NJIT-Solar-Car/can-io-board/assets/CubeMX_Config.png

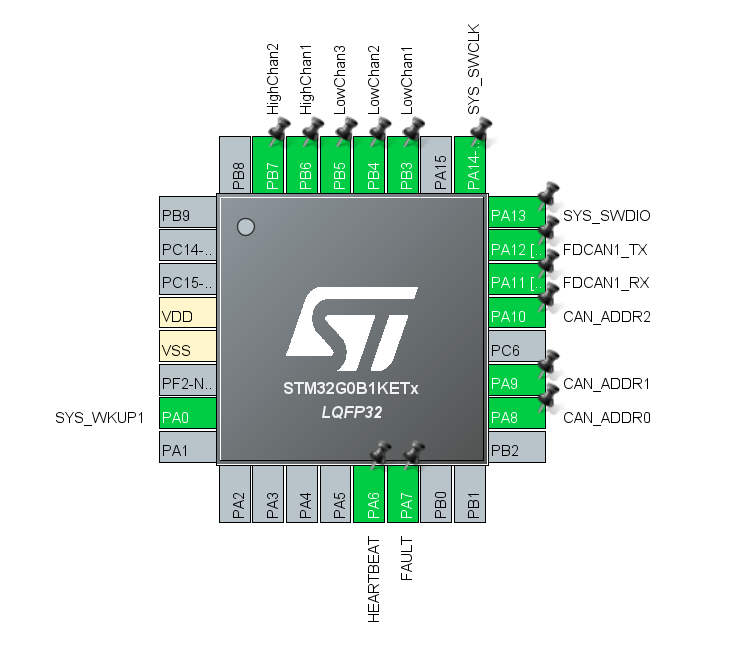
assets/CubeMX_Config.png
