NJIT-Solar-Car/can-io-board/Hardware/CAN.kicad_sch

## KiCad design Hardware/CAN.kicad_sch (2026-06-10)

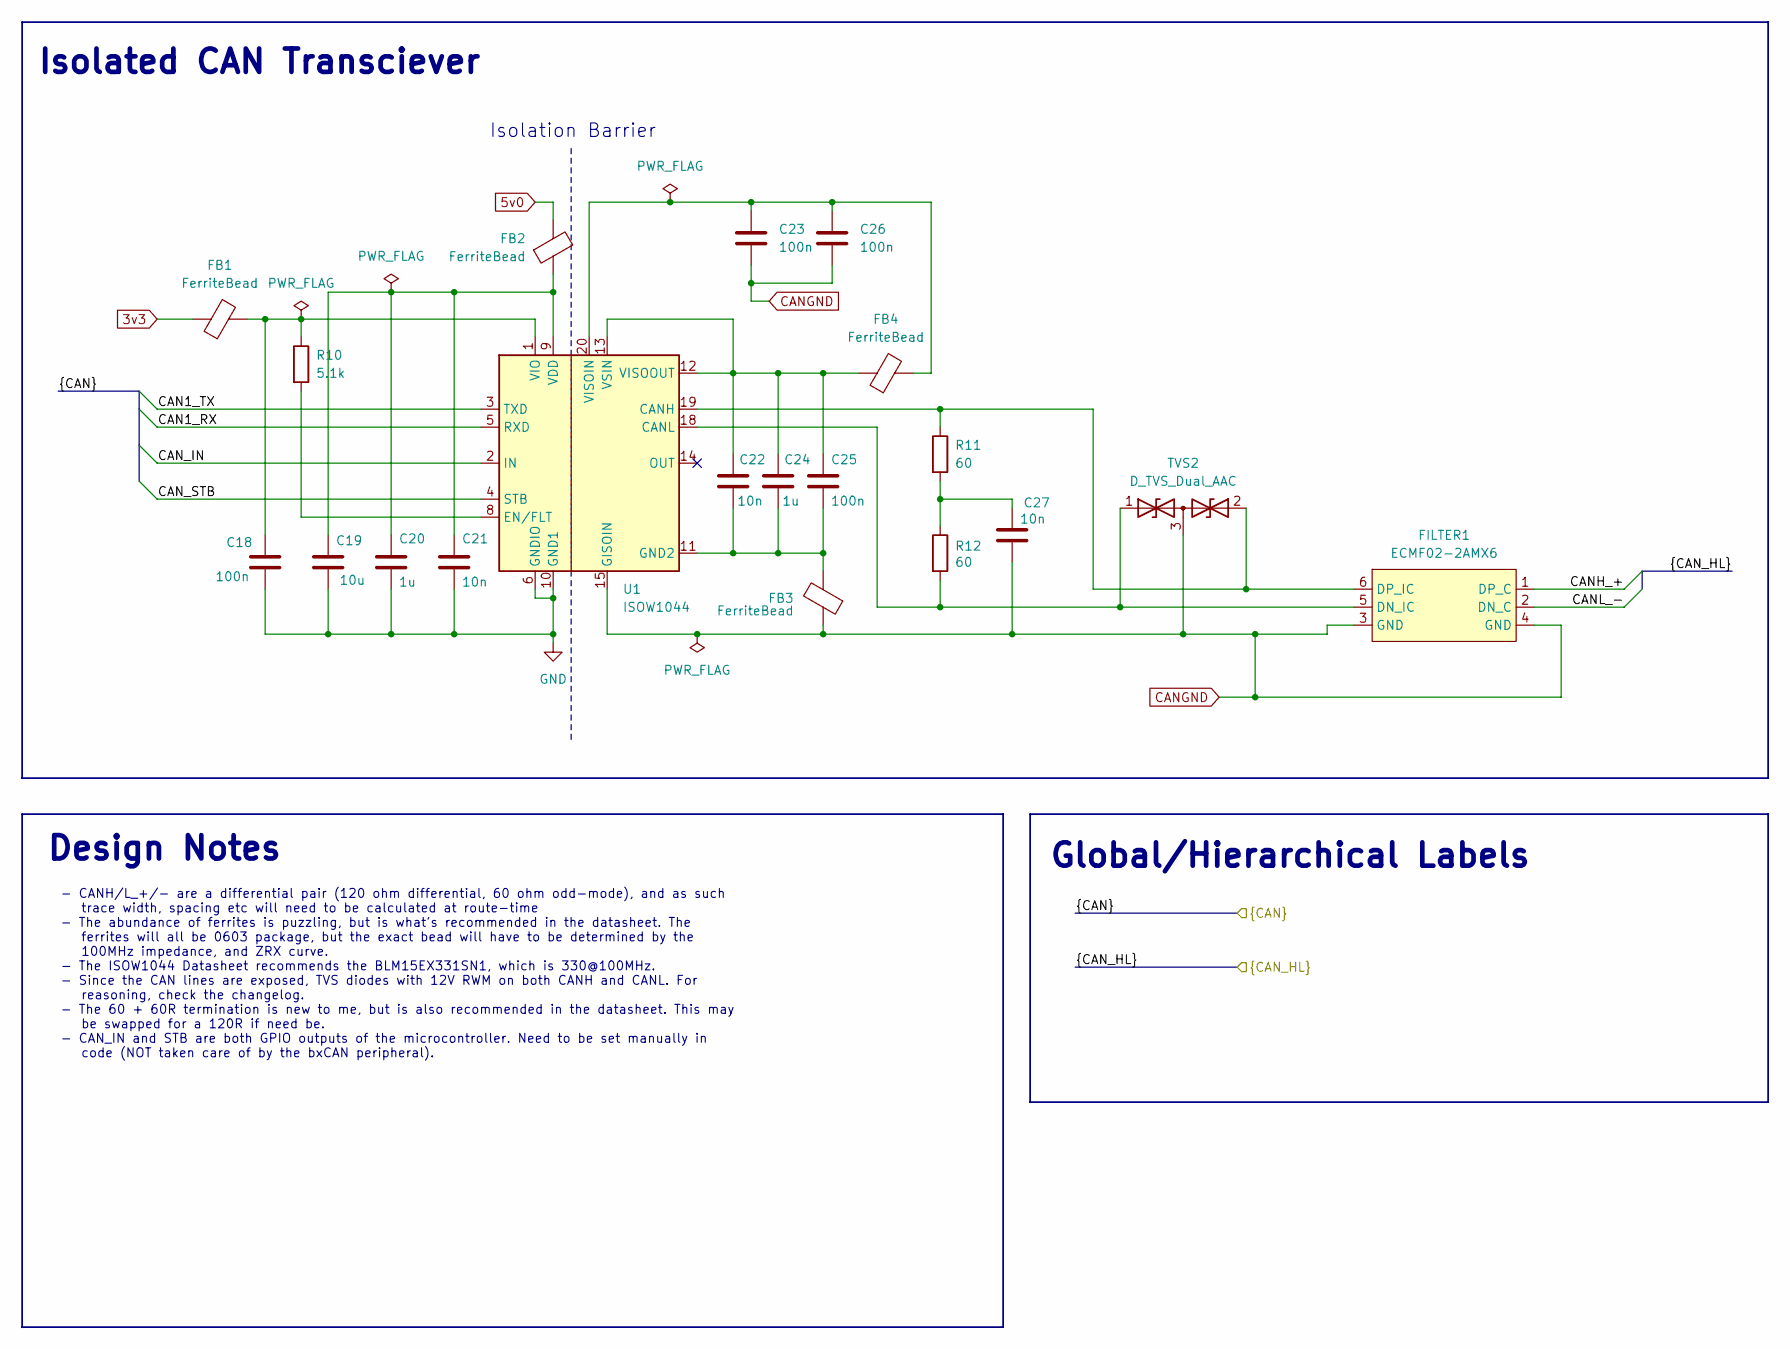
[picture p2: schematic CAN.kicad_sch]

Parts:
C18, C23, C25, C26: 100n; C_0603_1608Metric_Pad1.08x0.95mm_HandSolder
C19: 10u; C_0603_1608Metric_Pad1.08x0.95mm_HandSolder
C20, C24: 1u; C_0603_1608Metric_Pad1.08x0.95mm_HandSolder
C21, C22, C27: 10n; C_0603_1608Metric_Pad1.08x0.95mm_HandSolder
FB1, FB2, FB3, FB4: FerriteBead; L_0603_1608Metric_Pad1.05x0.95mm_HandSolder
FILTER1: ECMF02-2AMX6
R10: 5.1k; R_0603_1608Metric_Pad0.98x0.95mm_HandSolder
R11, R12: 60; R_0603_1608Metric_Pad0.98x0.95mm_HandSolder
TVS2: D_TVS_Dual_AAC; SOT-23-3
U1: ISOW1044; SOIC-20W_7.5x12.8mm_P1.27mm

Connections:
3v3: FB1.1
5v0: FB2.2
CAN1_RX: U1.5 (RXD)
CAN1_TX: U1.3 (TXD)
CANGND: C23.2, C26.2, C27.2, FB3.1, FILTER1.3 (GND), FILTER1.4 (GND), TVS2.3 (common), U1.15 (GISOIN), U1.16 (GISOIN), U1.17 (GISOIN)
CANH_+: FILTER1.1 (DP_C)
CANL_-: FILTER1.2 (DN_C)
CAN_IN: U1.2 (IN)
CAN_STB: U1.4 (STB)
GND: C18.2, C19.2, C20.2, C21.2, U1.6 (GNDIO), U1.10 (GND1)
unnamed: C18.1, FB1.2, R10.1, U1.1 (VIO)
unnamed: C19.1, C20.1, C21.1, FB2.1, U1.9 (VDD)
unnamed: C22.1, C24.1, C25.1, FB4.1, U1.12 (VISOOUT), U1.13 (VSIN)
unnamed: C22.2, C24.2, C25.2, FB3.2, U1.11 (GND2)
unnamed: C23.1, C26.1, FB4.2, U1.20 (VISOIN)
unnamed: C27.1, R11.2, R12.1
unnamed: FILTER1.5 (DN_IC), R12.2, TVS2.1 (A1), U1.18 (CANL)
unnamed: FILTER1.6 (DP_IC), R11.1, TVS2.2 (A2), U1.19 (CANH)
unnamed: R10.2, U1.8 (EN/FLT)

Notes on the sheet:
- CANH/L_+/- are a differential pair (120 ohm differential, 60 ohm odd-mode), and as such trace width, spacing etc will need to be calculated at route-time - The abundance of ferrites is puzzling, but is what's recommended in the datasheet. The ferrites will all be 0603 package, but the exact bead 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
Design Notes
Isolated CAN Transciever
Global/Hierarchical Labels
Isolation Barrier
