NJIT-Solar-Car/can-io-board/Hardware/Connectors.kicad_sch

## KiCad design Hardware/Connectors.kicad_sch (2026-06-10)

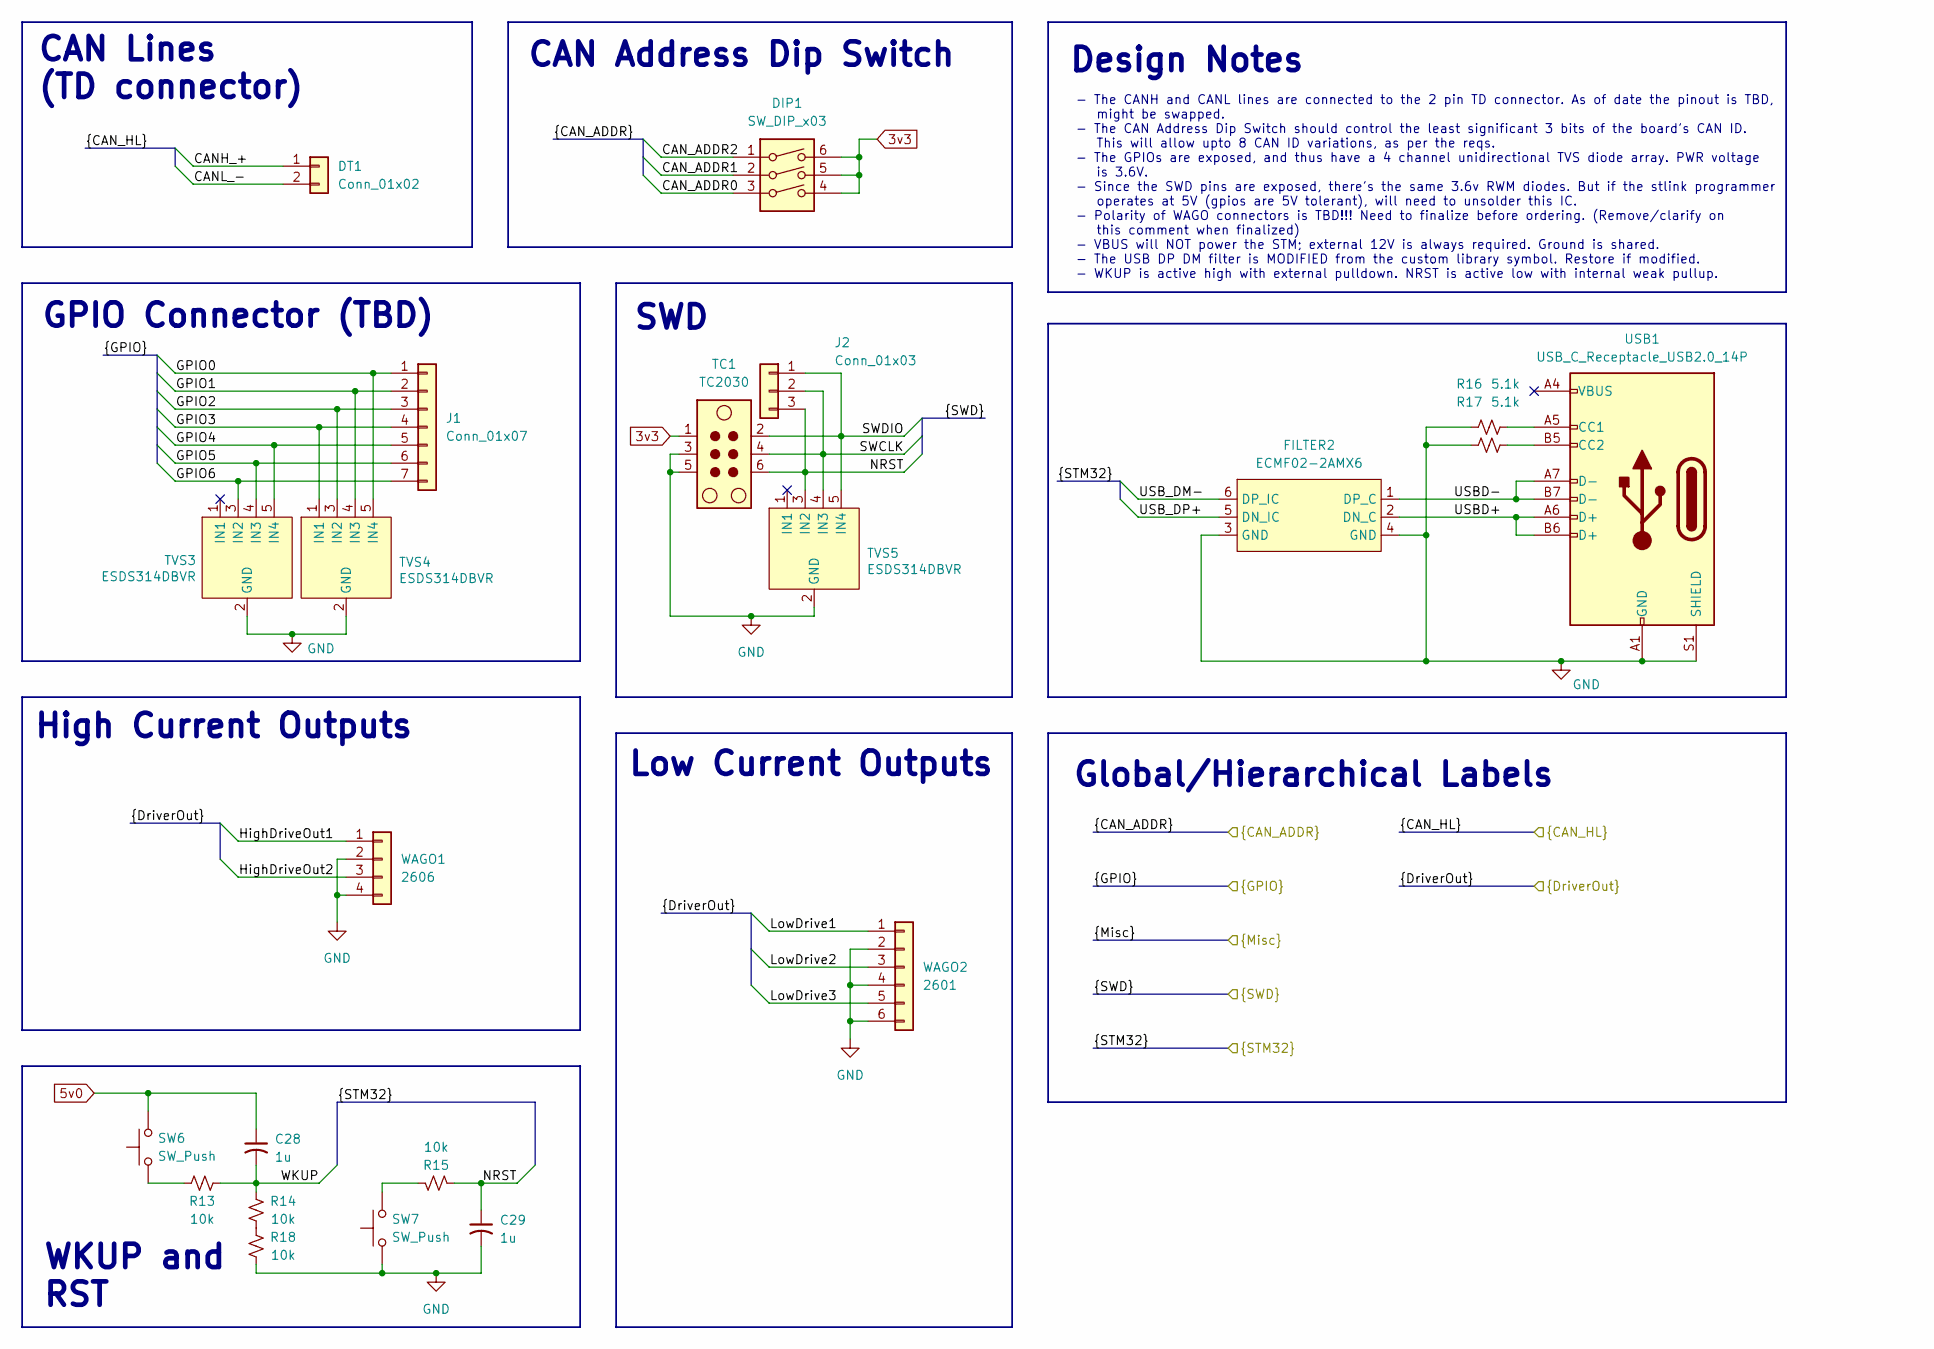
[picture p3: schematic Connectors.kicad_sch]

Parts:
C28, C29: 1u; C_0603_1608Metric_Pad1.08x0.95mm_HandSolder
DIP1: SW_DIP_x03; SW_DIP_SPSTx03_Slide_9.78x9.8mm_W7.62mm_P2.54mm
DT1: Conn_01x02; TerminalBlock_MaiXu_MX126-5.0-02P_1x02_P5.00mm
FILTER2: ECMF02-2AMX6
J1: Conn_01x07; PinHeader_1x07_P2.54mm_Vertical
J2: Conn_01x03; PinHeader_1x03_P2.54mm_Vertical
R13, R14, R15, R18: 10k; R_0603_1608Metric_Pad0.98x0.95mm_HandSolder
R16, R17: 5.1k; R_0603_1608Metric_Pad0.98x0.95mm_HandSolder
SW6, SW7: SW_Push; SW_Push_1P1T_NO_CK_KSC7xxJ
TC1: TC2030; Tag-Connect_TC2030-IDC-NL_2x03_P1.27mm_Vertical
TVS3, TVS4, TVS5: ESDS314DBVR; SOT-23-5
USB1: USB_C_Receptacle_USB2.0_14P
WAGO1: 2606
WAGO2: 2601; TerminalBlock_WAGO_2601-1106_1x06_P3.50mm_Horizontal

Connections:
3v3: DIP1.4, DIP1.5, DIP1.6, TC1.1
5v0: C28.1, SW6.2
CANH_+: DT1.1
CANL_-: DT1.2
CAN_ADDR0: DIP1.3
CAN_ADDR1: DIP1.2
CAN_ADDR2: DIP1.1
GND: C29.2, FILTER2.3 (GND), FILTER2.4 (GND), R16.1, R17.1, R18.2, SW7.1, TC1.3, TC1.5, TVS3.2 (GND), TVS4.2 (GND), TVS5.2 (GND), USB1.A1 (GND), USB1.A12 (GND), USB1.B1 (GND), USB1.B12 (GND), USB1.S1 (SHIELD), WAGO1.2, WAGO1.4, WAGO2.2, WAGO2.4, WAGO2.6
GPIO0: J1.1, TVS4.5 (IN4)
GPIO1: J1.2, TVS4.4 (IN3)
GPIO2: J1.3, TVS4.3 (IN2)
GPIO3: J1.4, TVS4.1 (IN1)
GPIO4: J1.5, TVS3.5 (IN4)
GPIO5: J1.6, TVS3.4 (IN3)
GPIO6: J1.7, TVS3.3 (IN2)
HighDriveOut1: WAGO1.1
HighDriveOut2: WAGO1.3
LowDrive1: WAGO2.1
LowDrive2: WAGO2.3
LowDrive3: WAGO2.5
NRST: C29.1, J2.3, R15.1, TC1.6, TVS5.3 (IN2)
unnamed: R13.2, SW6.1
unnamed: R14.2, R18.1
unnamed: R15.2, SW7.2
unnamed: R16.2, USB1.A5 (CC1)
unnamed: R17.2, USB1.B5 (CC2)
unnamed: USB1.A4 (VBUS), USB1.A9 (VBUS), USB1.B4 (VBUS), USB1.B9 (VBUS)
SWCLK: J2.2, TC1.4, TVS5.4 (IN3)
SWDIO: J2.1, TC1.2, TVS5.5 (IN4)
USBD+: FILTER2.2 (DN_C), USB1.A6 (D+), USB1.B6 (D+)
USBD-: FILTER2.1 (DP_C), USB1.A7 (D-), USB1.B7 (D-)
USB_DM-: FILTER2.6 (DP_IC)
USB_DP+: FILTER2.5 (DN_IC)
WKUP: C28.2, R13.1, R14.1

Notes on the sheet:
High Current Outputs
Low Current Outputs
CAN Lines (TD connector)
CAN Address Dip Switch
SWD
WKUP and RST
- The CANH and CANL lines are connected to the 2 pin TD connector. As of date the pinout is TBD, might be swapped. - The CAN Address Dip Switch should control the least significant 3 bits of the board's CAN ID. This will allow upto 8 CAN ID variations, as per the reqs. - The GPIOs are exposed, and 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
Global/Hierarchical Labels
Design Notes
GPIO Connector (TBD)
