NJIT-Solar-Car/can-io-board/Hardware/Load_Driver.kicad_sch

## KiCad design Hardware/Load_Driver.kicad_sch (2026-06-10)

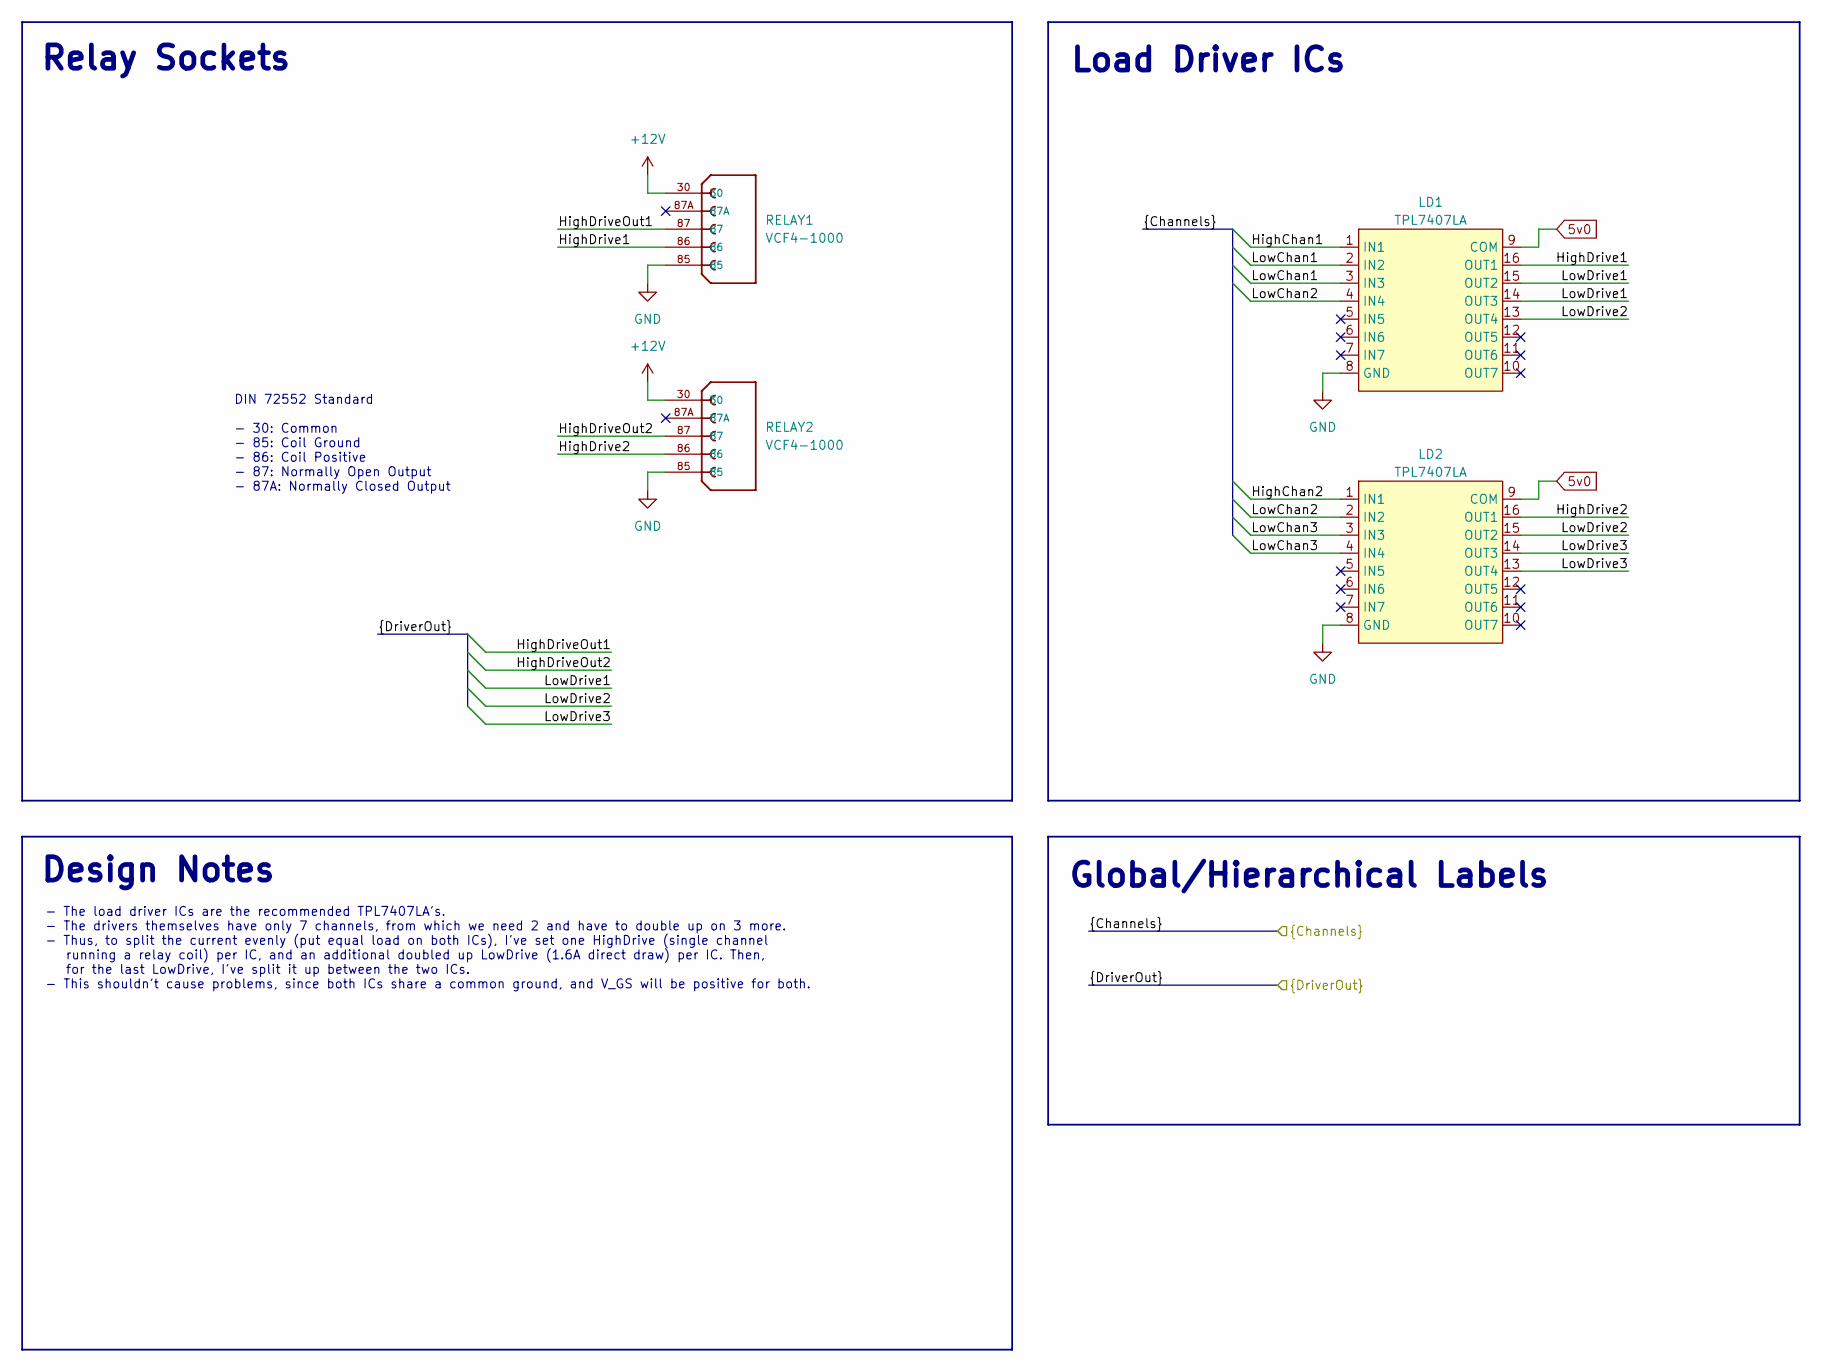
[picture p4: schematic Load_Driver.kicad_sch]

Parts:
LD1, LD2: TPL7407LA; SOIC-16_3.9x9.9mm_P1.27mm
RELAY1, RELAY2: VCF4-1000; TE_VCF4-1000; PARTREV B

Connections:
5v0: LD1.9 (COM), LD2.9 (COM)
+12V: RELAY1.30, RELAY2.30
GND: LD1.8 (GND), LD2.8 (GND), RELAY1.85, RELAY2.85
HighChan1: LD1.1 (IN1)
HighChan2: LD2.1 (IN1)
HighDrive1: LD1.16 (OUT1), RELAY1.86
HighDrive2: LD2.16 (OUT1), RELAY2.86
HighDriveOut1: RELAY1.87
HighDriveOut2: RELAY2.87
LowChan1: LD1.2 (IN2), LD1.3 (IN3)
LowChan2: LD1.4 (IN4), LD2.2 (IN2)
LowChan3: LD2.3 (IN3), LD2.4 (IN4)
LowDrive1: LD1.14 (OUT3), LD1.15 (OUT2)
LowDrive2: LD1.13 (OUT4), LD2.15 (OUT2)
LowDrive3: LD2.13 (OUT4), LD2.14 (OUT3)

Notes on the sheet:
Relay Sockets
Load Driver ICs
Design Notes
- The load driver ICs are the recommended TPL7407LA's. - The drivers themselves have only 7 channels, from which we need 2 and have to double up on 3 more. - Thus, to split the current evenly (put equal load on both ICs), I've set one HighDrive (single channel running a relay coil) per IC, and an a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
Global/Hierarchical Labels
DIN 72552 Standard - 30: Common - 85: Coil Ground - 86: Coil Positive - 87: Normally Open Output - 87A: Normally Closed Output
