NJIT-Solar-Car/can-io-board/Hardware/Power.kicad_sch

## KiCad design Hardware/Power.kicad_sch (2026-06-10)

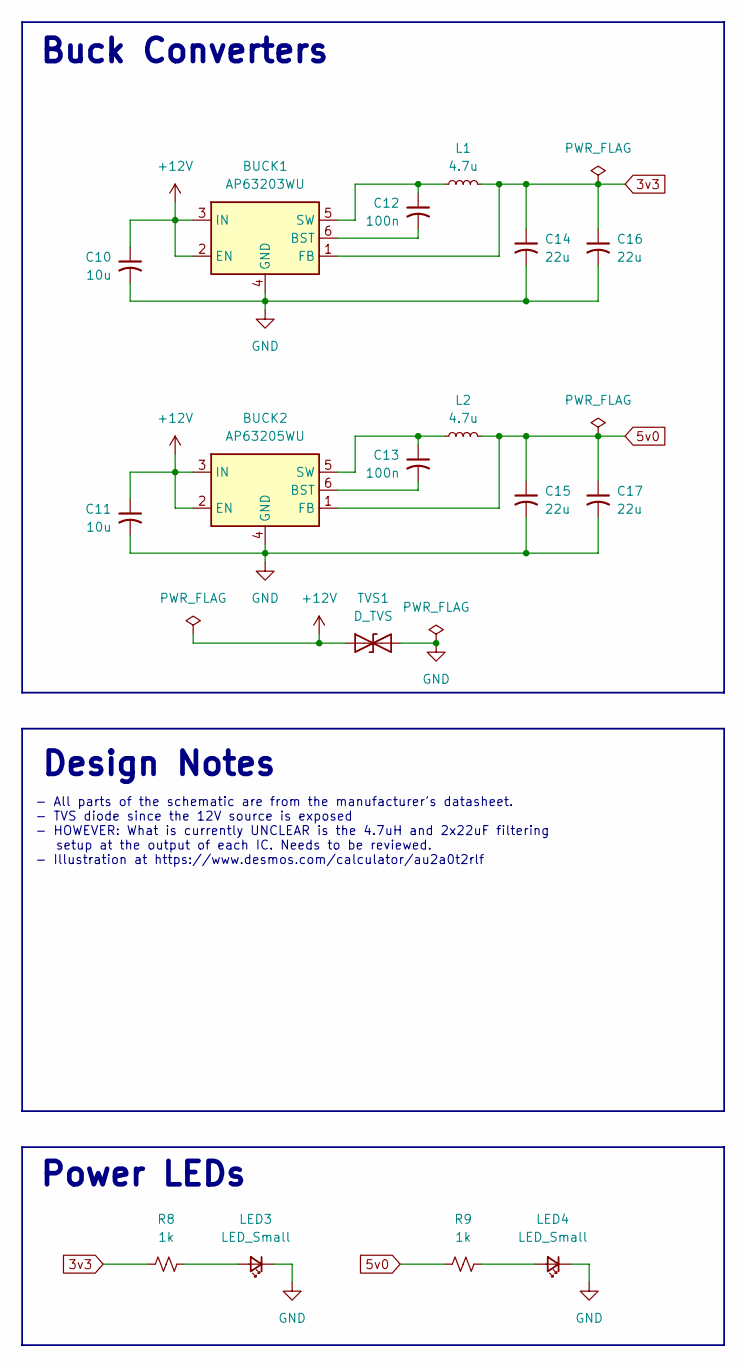
[picture p5: schematic Power.kicad_sch]

Parts:
BUCK1: AP63203WU; TSOT-23-6
BUCK2: AP63205WU; TSOT-23-6
C10, C11: 10u; C_0603_1608Metric_Pad1.08x0.95mm_HandSolder
C12, C13: 100n; C_0603_1608Metric_Pad1.08x0.95mm_HandSolder
C14, C15, C16, C17: 22u; CP_Elec_4x4.5
L1, L2: 4.7u; L_Axial_L7.0mm_D3.3mm_P5.08mm_Vertical_Fastron_MICC
LED3, LED4: LED_Small; LED_1206_3216Metric_Pad1.42x1.75mm_HandSolder
R8, R9: 1k; R_0603_1608Metric_Pad0.98x0.95mm_HandSolder
TVS1: D_TVS; D_SMA_Handsoldering

Connections:
3v3: BUCK1.1 (FB), C14.1, C16.1, L1.2, R8.1
5v0: BUCK2.1 (FB), C15.1, C17.1, L2.2, R9.1
+12V: BUCK1.2 (EN), BUCK1.3 (IN), BUCK2.2 (EN), BUCK2.3 (IN), C10.1, C11.1, TVS1.1 (A1)
GND: BUCK1.4 (GND), BUCK2.4 (GND), C10.2, C11.2, C14.2, C15.2, C16.2, C17.2, LED3.1 (K), LED4.1 (K), TVS1.2 (A2)
unnamed: BUCK1.5 (SW), C12.1, L1.1
unnamed: BUCK1.6 (BST), C12.2
unnamed: BUCK2.5 (SW), C13.1, L2.1
unnamed: BUCK2.6 (BST), C13.2
unnamed: LED3.2 (A), R8.2
unnamed: LED4.2 (A), R9.2

Notes on the sheet:
- All parts of the schematic are from the manufacturer's datasheet. - TVS diode since the 12V source is exposed - HOWEVER: What is currently UNCLEAR is the 4.7uH and 2x22uF filtering setup at the output of each IC. Needs to be reviewed. - Illustration at https://www.desmos.com/calculator/au2a0t2rlf
Buck Converters
Power LEDs
Design Notes
