NJIT-Solar-Car/can-io-board/Hardware/STM32G0B1.kicad_sch

## KiCad design Hardware/STM32G0B1.kicad_sch (2026-06-10)

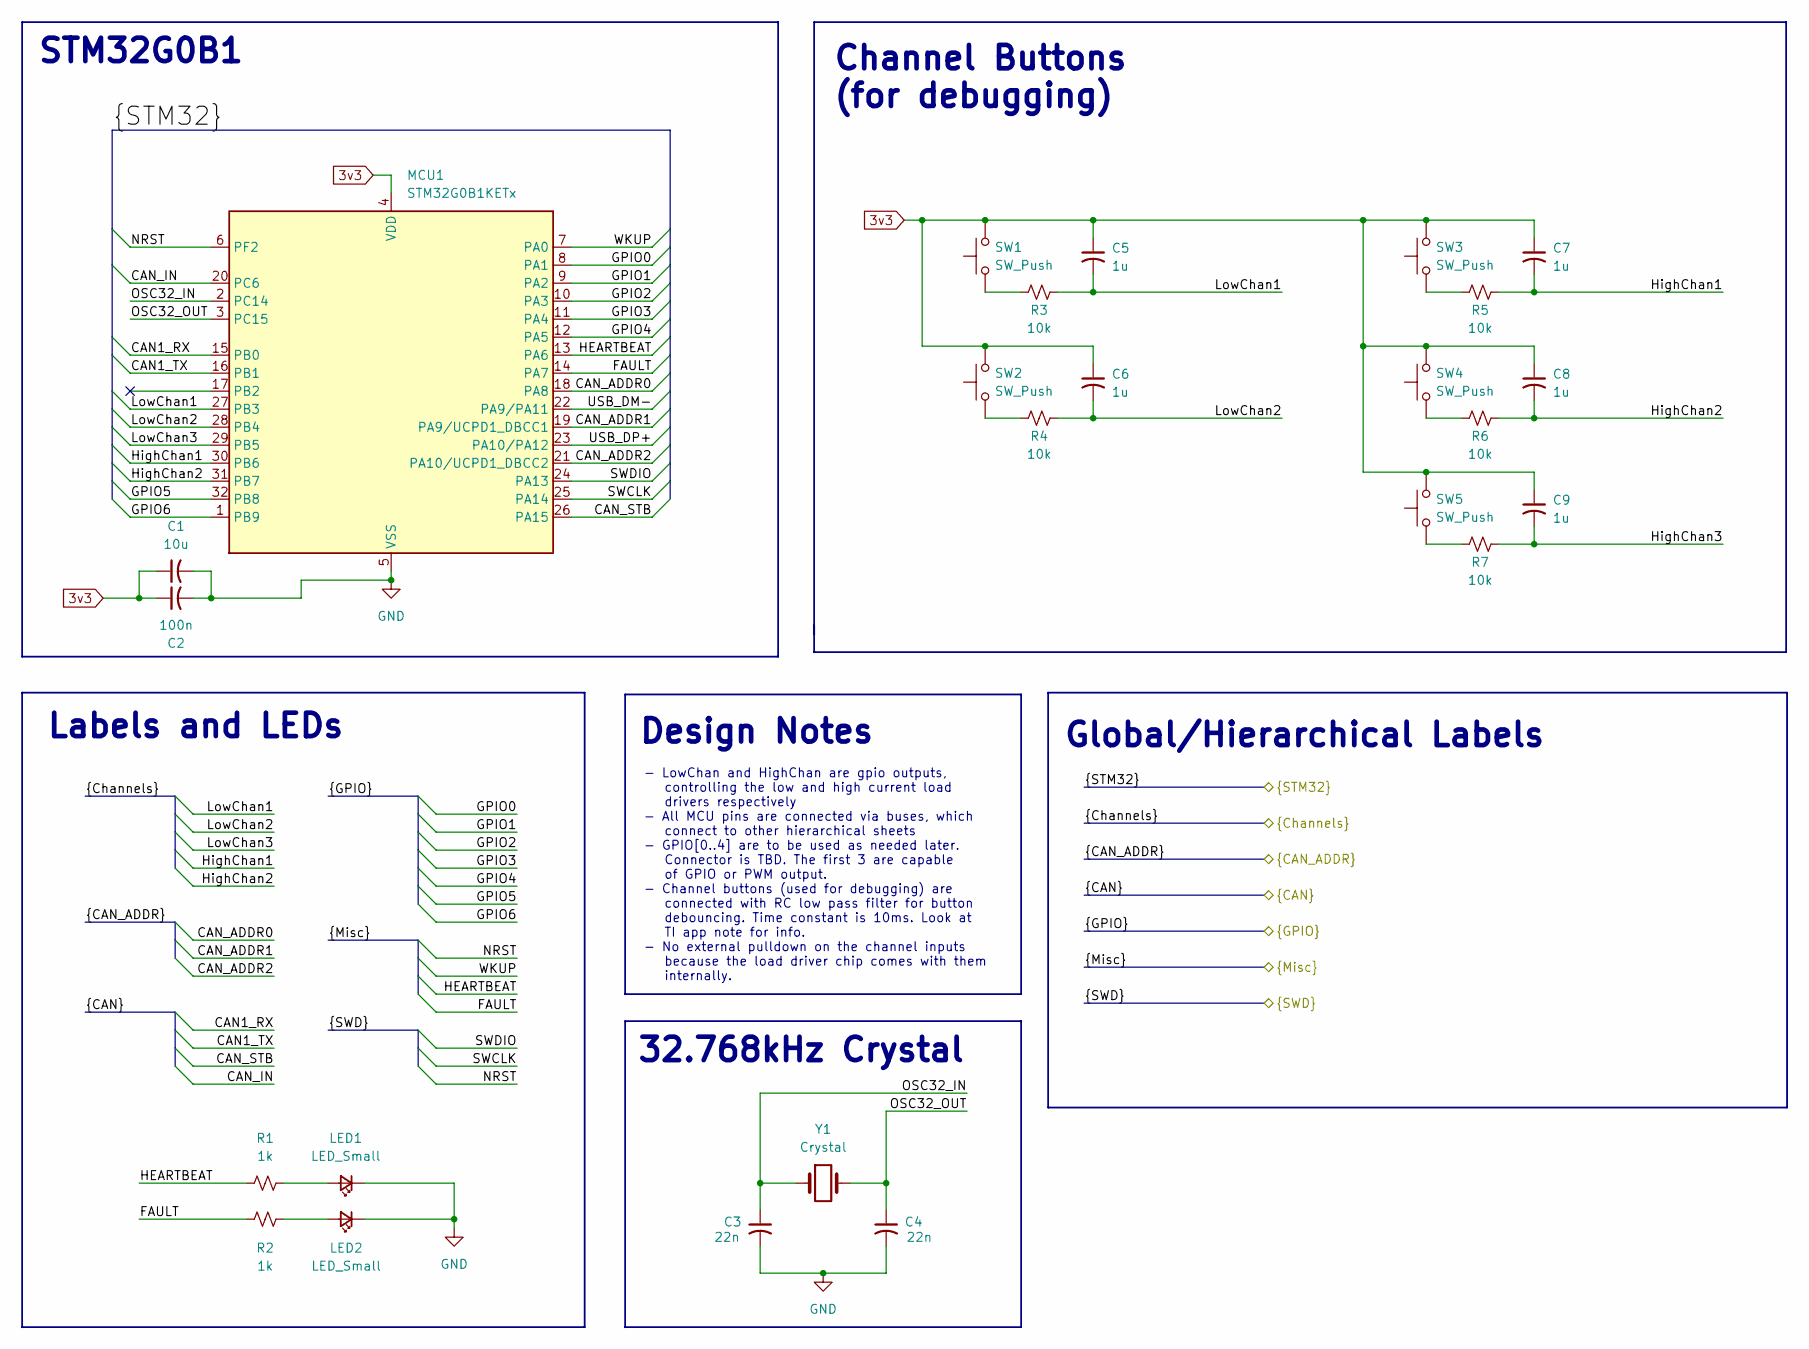
[picture p6: schematic STM32G0B1.kicad_sch]

Parts:
C1: 10u; C_0603_1608Metric_Pad1.08x0.95mm_HandSolder
C2: 100n; C_0603_1608Metric_Pad1.08x0.95mm_HandSolder
C3, C4: 22n; C_0603_1608Metric_Pad1.08x0.95mm_HandSolder
C5, C6, C7, C8, C9: 1u; C_0603_1608Metric_Pad1.08x0.95mm_HandSolder
LED1, LED2: LED_Small; LED_1206_3216Metric_Pad1.42x1.75mm_HandSolder
MCU1: STM32G0B1KETx; LQFP-32_7x7mm_P0.8mm
R1, R2: 1k; R_0603_1608Metric_Pad0.98x0.95mm_HandSolder
R3, R4, R5, R6, R7: 10k; R_0603_1608Metric_Pad0.98x0.95mm_HandSolder
SW1, SW2, SW3, SW4, SW5: SW_Push; SW_Push_1P1T_NO_CK_KSC7xxJ
Y1: Crystal; Crystal_SMD_3215-2Pin_3.2x1.5mm

Connections:
3v3: C1.1, C2.1, C5.1, C6.1, C7.1, C8.1, C9.1, MCU1.4 (VDD), SW1.2, SW2.2, SW3.2, SW4.2, SW5.2
CAN1_RX: MCU1.15 (PB0)
CAN1_TX: MCU1.16 (PB1)
CAN_ADDR0: MCU1.18 (PA8)
CAN_ADDR1: MCU1.19 (PA9/UCPD1_DBCC1)
CAN_ADDR2: MCU1.21 (PA10/UCPD1_DBCC2)
CAN_IN: MCU1.20 (PC6)
CAN_STB: MCU1.26 (PA15)
FAULT: MCU1.14 (PA7), R2.1
GND: C1.2, C2.2, C3.2, C4.2, LED1.1 (K), LED2.1 (K), MCU1.5 (VSS)
GPIO0: MCU1.8 (PA1)
GPIO1: MCU1.9 (PA2)
GPIO2: MCU1.10 (PA3)
GPIO3: MCU1.11 (PA4)
GPIO4: MCU1.12 (PA5)
GPIO5: MCU1.32 (PB8)
GPIO6: MCU1.1 (PB9)
HEARTBEAT: MCU1.13 (PA6), R1.1
HighChan1: C7.2, MCU1.30 (PB6), R5.1
HighChan2: C8.2, MCU1.31 (PB7), R6.1
HighChan3: C9.2, R7.1
LowChan1: C5.2, MCU1.27 (PB3), R3.1
LowChan2: C6.2, MCU1.28 (PB4), R4.1
LowChan3: MCU1.29 (PB5)
NRST: MCU1.6 (PF2)
unnamed: LED1.2 (A), R1.2
unnamed: LED2.2 (A), R2.2
unnamed: R3.2, SW1.1
unnamed: R4.2, SW2.1
unnamed: R5.2, SW3.1
unnamed: R6.2, SW4.1
unnamed: R7.2, SW5.1
OSC32_IN: C3.1, MCU1.2 (PC14), Y1.1
OSC32_OUT: C4.1, MCU1.3 (PC15), Y1.2
SWCLK: MCU1.25 (PA14)
SWDIO: MCU1.24 (PA13)
USB_DM-: MCU1.22 (PA9/PA11)
USB_DP+: MCU1.23 (PA10/PA12)
WKUP: MCU1.7 (PA0)

Notes on the sheet:
Labels and LEDs
32.768kHz Crystal
Channel Buttons (for debugging)
STM32G0B1
- LowChan and HighChan are gpio outputs, controlling the low and high current load drivers respectively - All MCU pins are connected via buses, which connect to other hierarchical sheets - GPIO[0..4] are to be used as needed later. Connector is TBD. The first 3 are capable of GPIO or PWM output. - 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
Global/Hierarchical Labels
Design Notes
