NJIT-Solar-Car/can-io-board/Hardware/old.kicad_sch

## KiCad design Hardware/old.kicad_sch (2026-06-08, an earlier design)

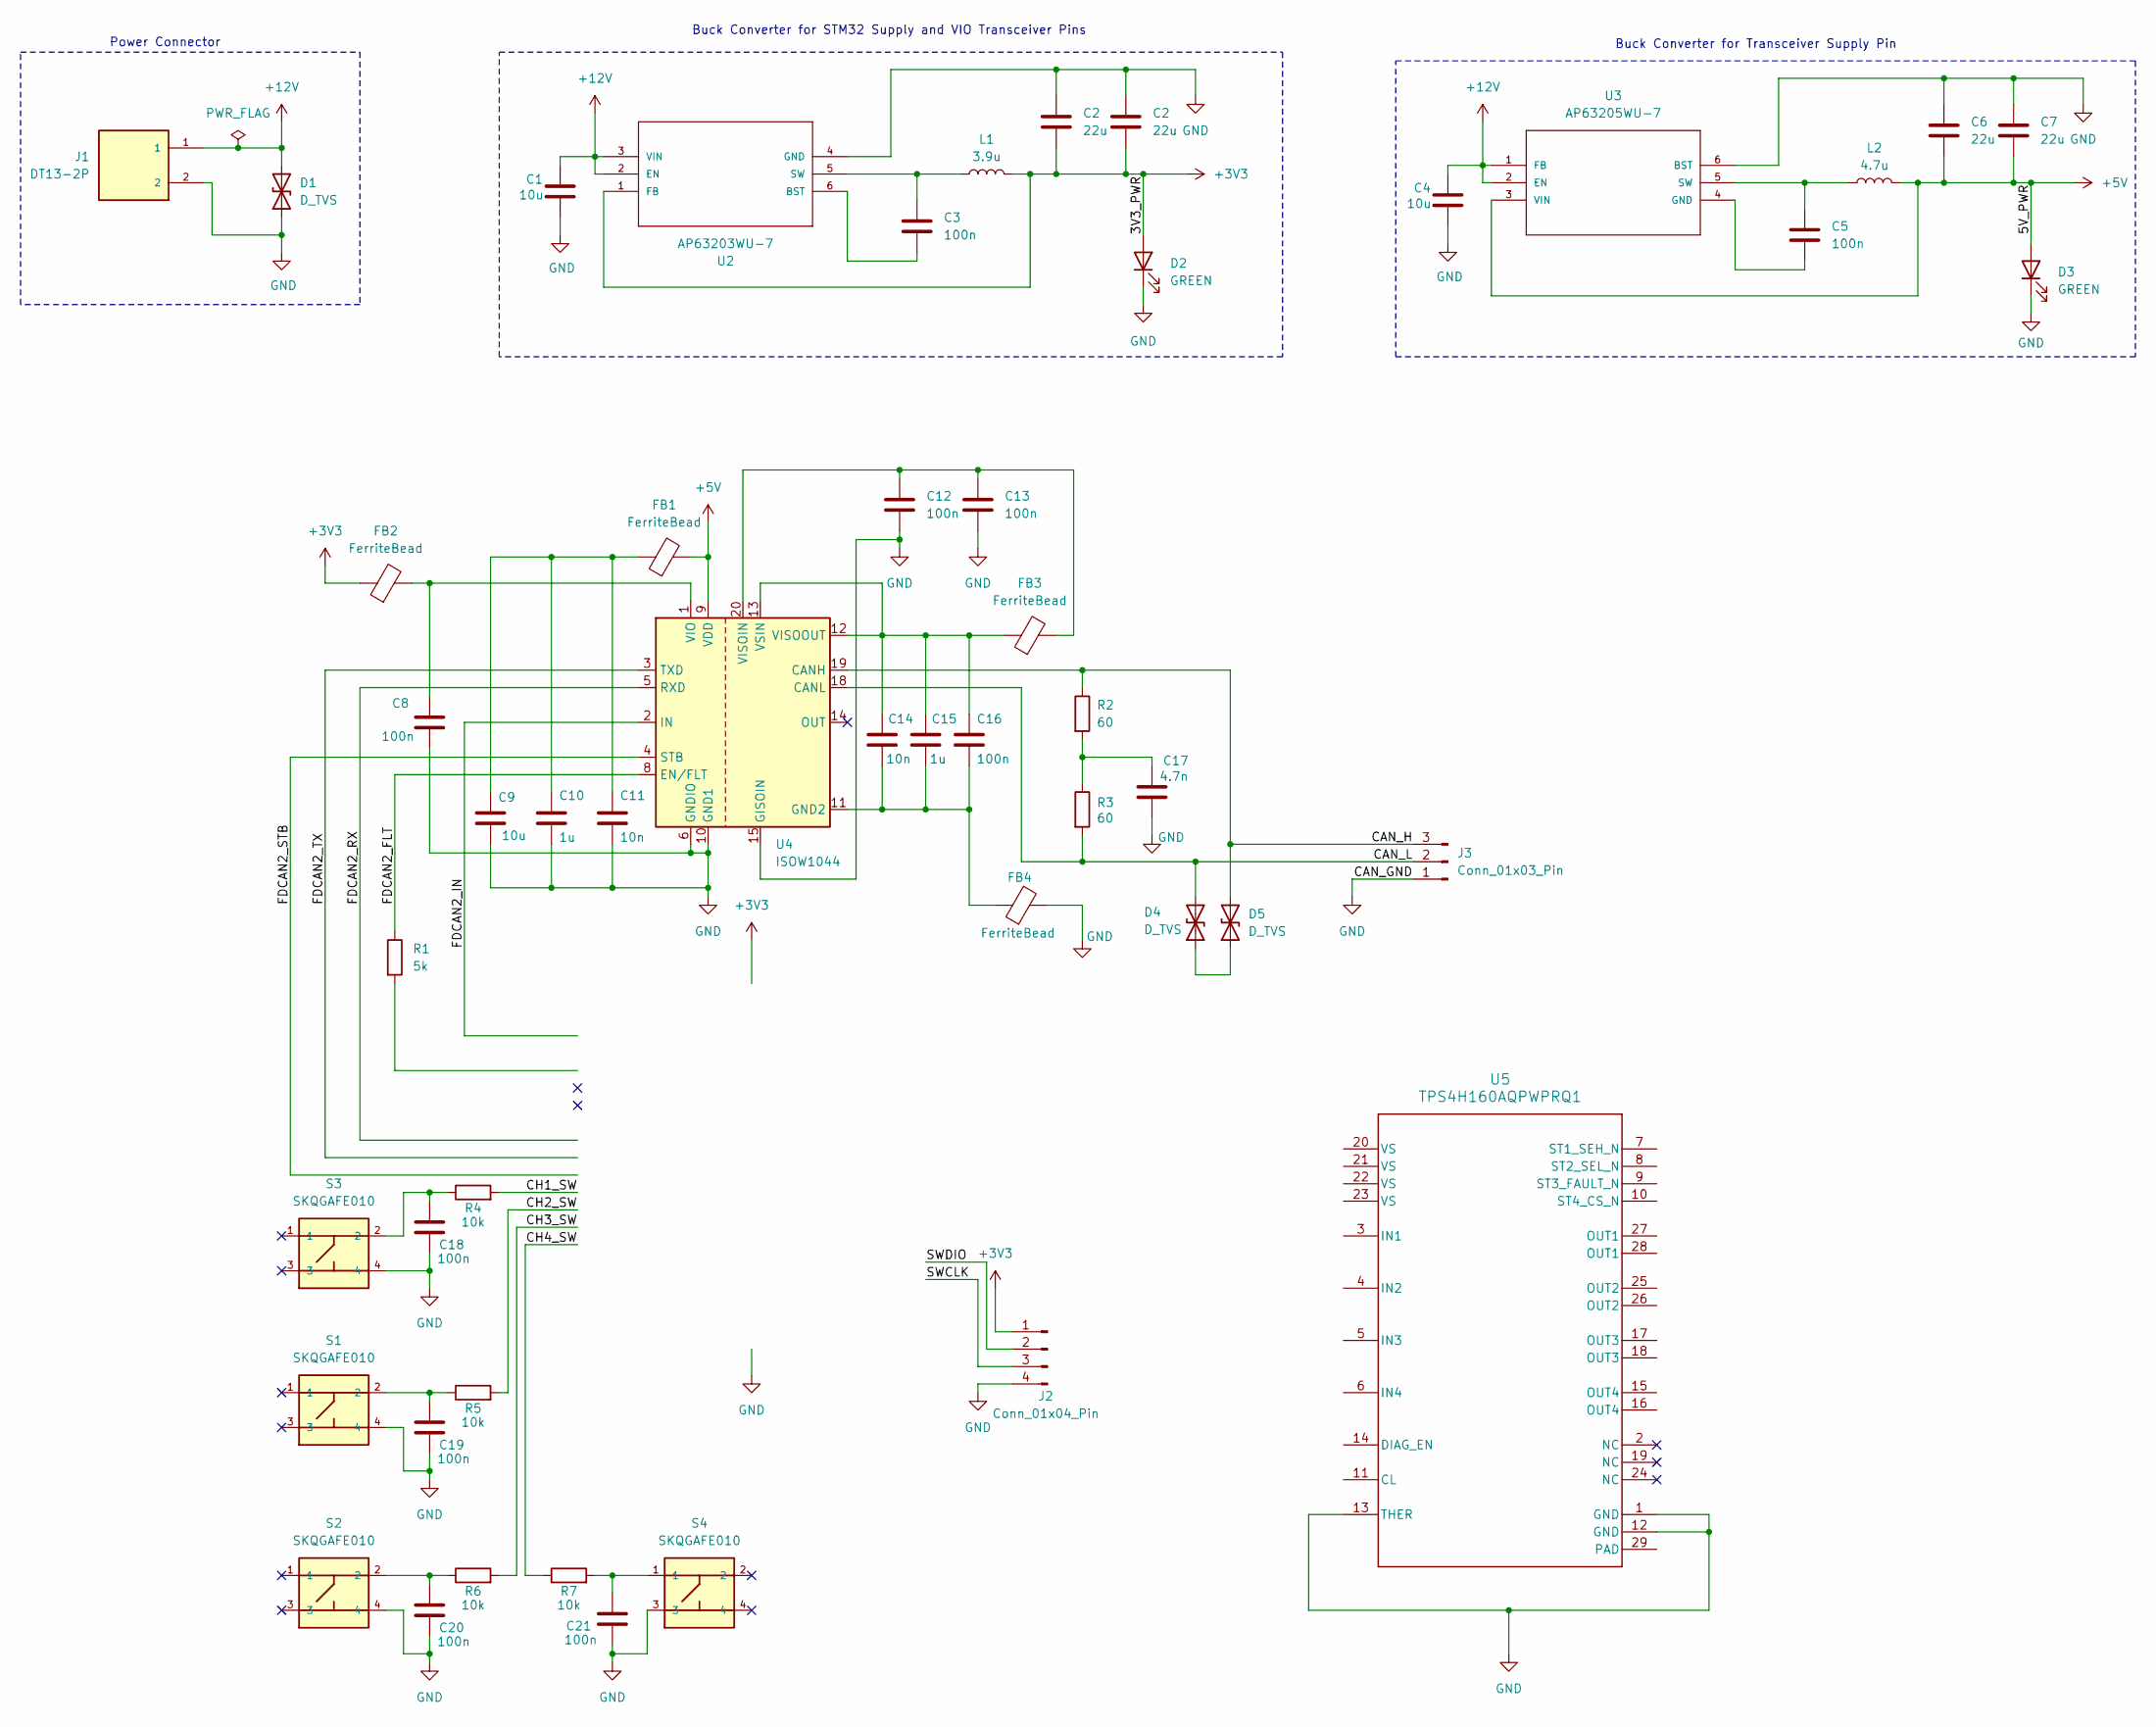
[picture p7: schematic old.kicad_sch]

Parts:
C1, C4, C9: 10u
C2, C6, C7: 22u
C3, C5, C8, C12, C13, C16, C18, C19, C20, C21: 100n
C10, C15: 1u
C11, C14: 10n
C17: 4.7n
D1, D4, D5: D_TVS
D2, D3: GREEN
FB1, FB2, FB3, FB4: FerriteBead; BEADC1005X55N
J1: DT13-2P; TE_DT13-2P; MPN DT13-2P
J2: Conn_01x04_Pin
J3: Conn_01x03_Pin
L1: 3.9u
L2: 4.7u
R1: 5k
R2, R3: 60
R4, R5, R6, R7: 10k
S1, S2, S3, S4: SKQGAFE010; SW_SKQGAFE010; PART_REV B1
U2: AP63203WU-7; SOIC_05WU-7_DIO-M; MPN AP63203WU-7
U3: AP63205WU-7; SOIC_05WU-7_DIO-M; MPN AP63205WU-7
U4: ISOW1044; SOIC-20W_7.5x12.8mm_P1.27mm
U5: TPS4H160AQPWPRQ1; PWP0028C_N

Connections:
+3V3: C2.2, D2.2 (A), FB2.1, J2.1, L1.2, U2.1 (FB)
+5V: C6.2, C7.2, D3.2 (A), FB1.2, L2.2, U3.3 (VIN), U4.9 (VDD)
+12V: C1.1, C4.1, D1.2 (A2), J1.1, U2.2 (EN), U2.3 (VIN), U3.1 (FB), U3.2 (EN)
CAN_H: D5.2 (A2), J3.3, R2.1, U4.19 (CANH)
CAN_L: D4.2 (A2), J3.2, R3.2, U4.18 (CANL)
CH1_SW: R4.2
CH2_SW: R5.2
CH3_SW: R6.2
CH4_SW: R7.1
FDCAN2_FLT: R1.1, U4.8 (EN/FLT)
FDCAN2_IN: U4.2 (IN)
FDCAN2_RX: U4.5 (RXD)
FDCAN2_STB: U4.4 (STB)
FDCAN2_TX: U4.3 (TXD)
GND: C1.2, C2.1, C4.2, C6.1, C7.1, C8.2, C9.2, C10.2, C11.2, C12.2, C13.2, C17.2, C18.2, C19.2, C20.2, C21.2, D1.1 (A1), D2.1 (K), D3.1 (K), FB4.2, J1.2, J2.4, J3.1, S1.4, S2.4, S3.4, S4.3, U2.4 (GND), U3.6 (BST), U4.6 (GNDIO), U4.10 (GND1), U4.15 (GISOIN), U4.16 (GISOIN), U4.17 (GISOIN), U5.1 (GND), U5.12 (GND), U5.13 (THER)
unnamed: C3.1, L1.1, U2.5 (SW)
unnamed: C3.2, U2.6 (BST)
unnamed: C5.1, L2.1, U3.5 (SW)
unnamed: C5.2, U3.4 (GND)
unnamed: C8.1, FB2.2, U4.1 (VIO)
unnamed: C9.1, C10.1, C11.1, FB1.1
unnamed: C12.1, C13.1, FB3.2, U4.20 (VISOIN)
unnamed: C14.1, C15.1, C16.1, FB3.1, U4.12 (VISOOUT), U4.13 (VSIN)
unnamed: C14.2, C15.2, C16.2, FB4.1, U4.11 (GND2)
unnamed: C17.1, R2.2, R3.1
unnamed: C18.1, R4.1, S3.2
unnamed: C19.1, R5.1, S1.2
unnamed: C20.1, R6.1, S2.2
unnamed: C21.1, R7.2, S4.1
unnamed: D4.1 (A1), D5.1 (A1)
SWCLK: J2.3
SWDIO: J2.2

Notes on the sheet:
Buck Converter for Transceiver Supply Pin
Buck Converter for STM32 Supply and VIO Transceiver Pins
Power Connector
