NJIT-Solar-Car/can-io-board/Software/Software.ioc

Mcu.UserName=STM32G0B1KETx
PA0.Signal=SYS_WKUP1
PA10.GPIO_Label=CAN_ADDR2
PA10.Signal=GPIO_Input
PA13.Signal=SYS_SWDIO
PA14-BOOT0.Signal=SYS_SWCLK
PA6.GPIO_Label=HEARTBEAT
PA6.Signal=GPIO_Output
PA7.GPIO_Label=FAULT
PA7.Signal=GPIO_Output
PA8.GPIO_Label=CAN_ADDR0
PA8.Signal=GPIO_Input
PA9.GPIO_Label=CAN_ADDR1
PA9.Signal=GPIO_Input
PB3.GPIO_Label=LowChan1
PB3.Signal=GPIO_Output
PB4.GPIO_Label=LowChan2
PB4.Signal=GPIO_Output
PB5.GPIO_Label=LowChan3
PB5.Signal=GPIO_Output
PB6.GPIO_Label=HighChan1
PB6.Signal=GPIO_Output
PB7.GPIO_Label=HighChan2
PB7.Signal=GPIO_Output
