NJIT-Solar-Car/can-io-board/(commit log)

2026-06-08 Finished the STM sheet mostly
    - Added a bus for the STM32, as well as the individual peripherals
    - Added LEDs for the Heartbeat and Fault outputs.
    - Added 5 pushbuttons for the 5 channels, along with button debouncing
    - Refer to TI's button debouncing AN. RC low pass w/ 10ms time
    constant. UNSURE if the schematic is correct, someone will
    have to check.
    [CAN.kicad_sch, Connectors.kicad_sch, Load_Driver.kicad_sch, Power.kicad_sch, STM32G0B1.kicad_sch, old.kicad_sch]
2026-06-08 Added the power schematic
    - Finished the power schematic.
    - HOWEVER, there is some confusion (Arnav) about the post-supply
    filtering. Needs to be reviewed before ordering.
    [CANIO-Board.kicad_sch, Power.kicad_sch]
2026-06-10 Fixed up the schematic a little, and did *most* footprint assigning
    - Most footprints are assigned. Ones that arent either don't exist, or
    are out of stock at digikey and are thus not work making/adding.
    - Details of next steps will be put into changelog soon
    [CAN.kicad_sch, Connectors.kicad_sch, Load_Driver.kicad_sch, Power.kicad_sch, STM32G0B1.kicad_sch]
2026-06-11 Completed the PCB setup. Relevant calculations in the CHANGELOG.
    [CANIO-Board.kicad_pcb]
